Muhammad-Alli/Portable-weather-station/Hardware/PCB.png

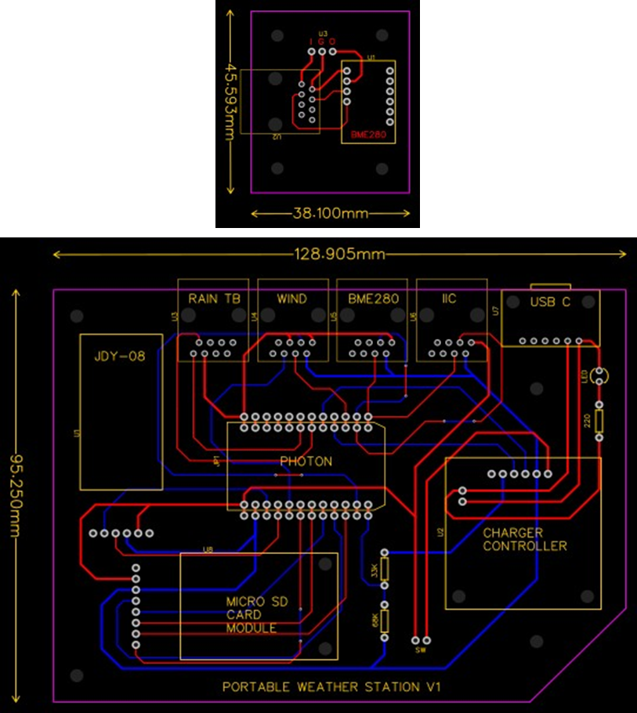
Hardware/PCB.png
