Muhammad-Alli/Portable-weather-station/Docs/Portable Weather Station_Project Summary.pdf

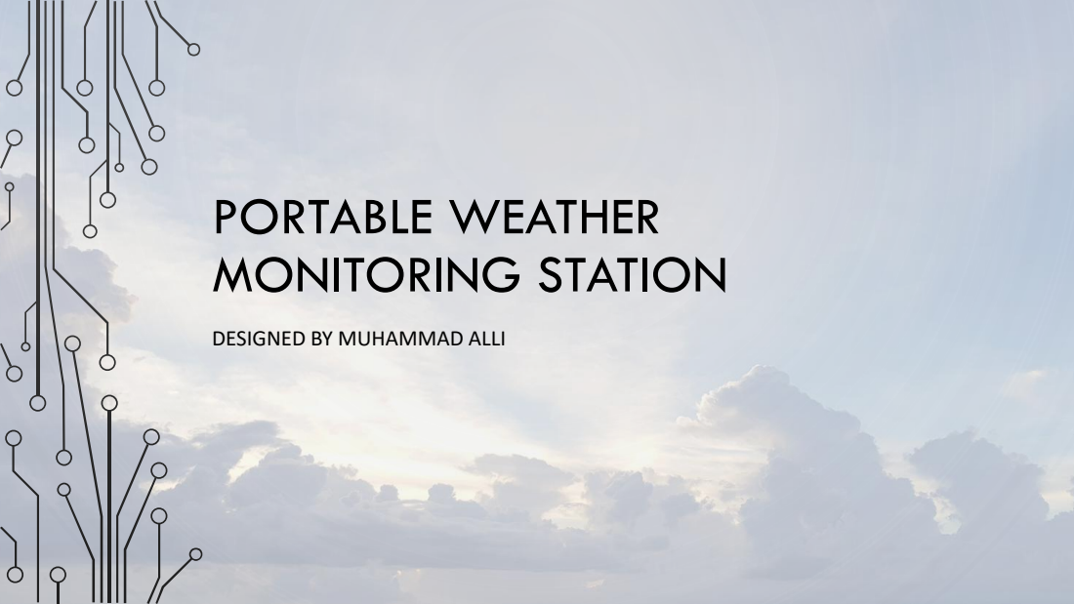
[picture p40: page 1]
PORTABLE WEATHER MONITORING STATION

DESIGNED BY MUHAMMAD ALLI

# Design Process

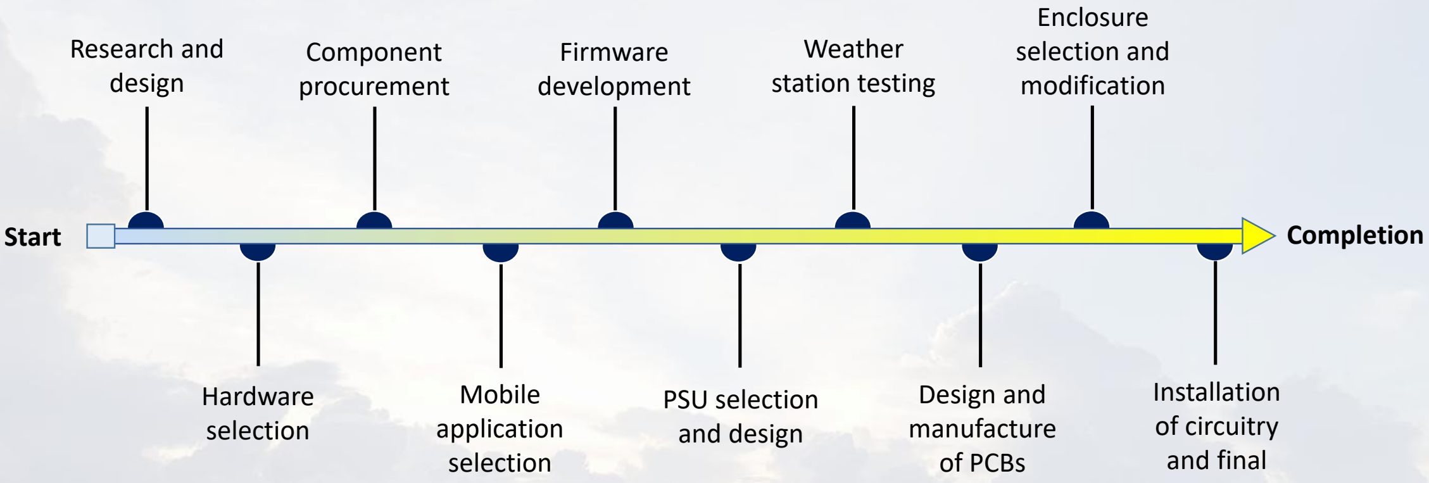
[picture p41: figure]
Start; Completion; Research and design; Mobile application selection; Hardware selection; Component procurement; Firmware development; PSU selection and design; Weather station testing; Design and manufacture of PCBs; Enclosure selection and modification; Installation of circuitry and final

testing

# Design process

# Background

Purpose:

To design and build a portable weather station that is capable of measuring and logging weather conditions in South Africa (all weather variable ranges were informed by the extremist weather conditions ever recorded in the country up to the time when this project was completed).

Applications:

Various industries:
- Agriculture: Irrigation control;
- Construction: Ensure employee safety when working at heights;
- Aviation: Ensure safe airplane landings and take-offs;
- Meteorology: Study of local weather conditions.

Design specifications:
•
- communicates sensor data to a mobile application via Bluetooth;
- has a 12-hour minimum period of operation;
- is able to log timestamped weather data.
Weather Variable | Design specification | Tolerance
Temperature | -22 to 55 °C | 2 °C
Pressure | 600 to 1050 hPa | ±10 hPa
Humidity | 0 to 100% | ±5%
Wind speed | 0 to 190 km/hr | ±10%
Wind direction | N, NE, E, SE, S, SW, W, NW | ±5%
Rain | 0 to 28 mm/hr | ±2 mm/hr

# Design

Block diagram:

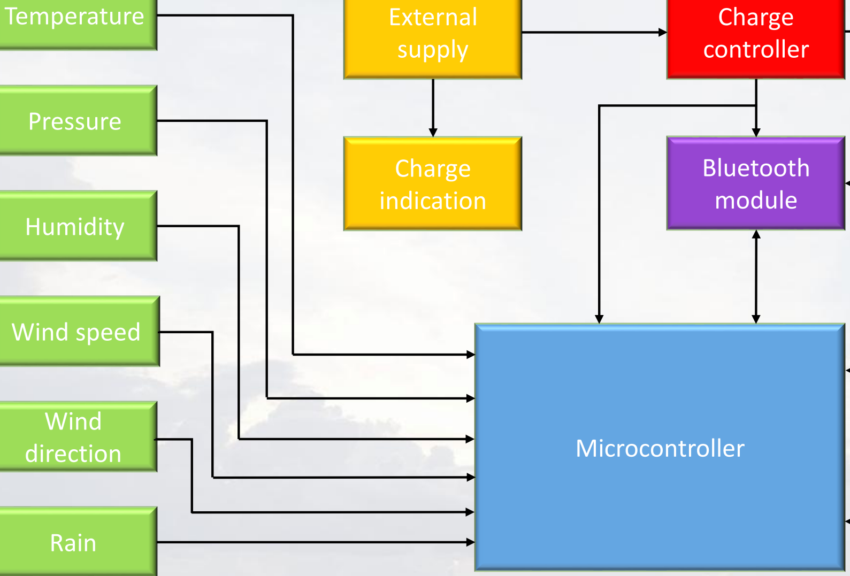
[picture p42: figure]
Temperature; Pressure; Humidity; Wind direction; Wind speed; Rain; Microcontroller; Charge controller; Bluetooth module; External supply; Charge indication

Rechargeable
battery

Battery
monitoring

Smart phone
application

Data logger

# Sensor selection

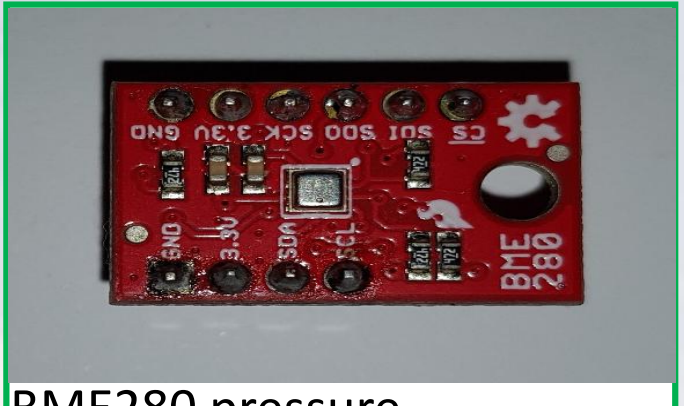
[picture p43: figure]
BME280 pressure
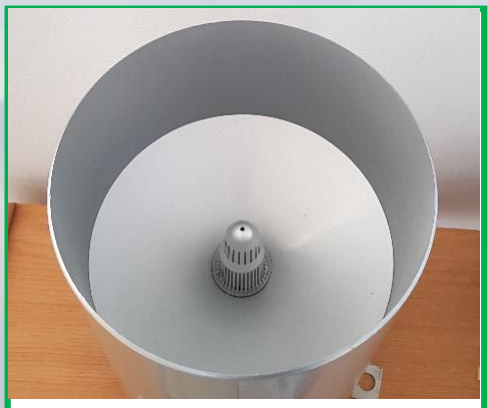
[picture p44: figure]

Sensor | Sensor Resolution | Sensor Range | Design specification
BME280: Temperature | 0.01 °C | -40 to 85 °C | -22 to 55 °C
BME280: Pressure | 0.18 Pa | 300 to 1100 hPa | 600 to 1050 hPa
BME280: Humidity | 0.008% | 0 to 100% | 0 to 100%
Davis 6410: Wind speed | 0.905 km/hr | 0 to 322 km/hr | 0 to 190 km/hr
Davis 6410: Wind direction | 1º | 0 to 360º | N, NE, E, SE, S, SW, W, NW
BGT WS-601ABS2: Rain | 0.8 mm/hr | 0 to 240 mm/hr | 0 to 28 mm/hr
Sensors: | Technical summary:

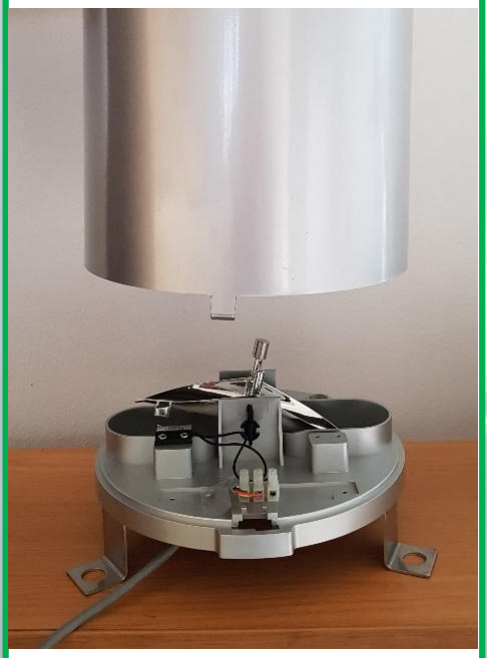
[picture p45: figure]

BGT WS-601ABS2
Rain Sensor

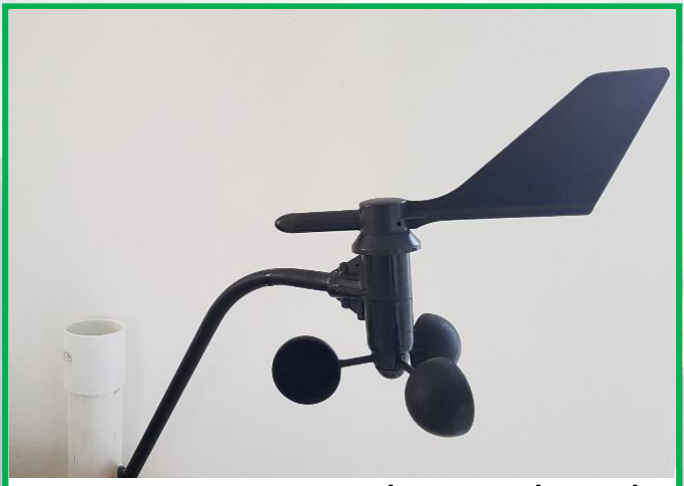
[picture p46: figure]

Davis 6410 wind speed and
direction sensor

temperature, and
humidity sensor

BME280 pressure,
temperature and humidity
sensor

Sensor | Sensor error | Design Tolerance
Wind speed | 8.3% (speed > 10m/s) 1m/s (speed < 10m/s) | 10% (speed > 10m/s) 1m/s (speed < 10m/s)
Wind direction | 4º | 5º
Temperature | 1.4 ℃ | 2 ℃
Humidity | 1.75% | 5%
Pressure | 1.46 hPa | 10 hPa
Rain | 0.8 mm/hr | 2 mm/hr

# Testing Results

Operation | Desired period of operation | Actual period of operation
Without cycling sleep mode | 12 hours | 16 hours and 41 minutes
With cycling sleep mode | 12 hours | 18 hours and 17 minutes

# Weather station main hardware and interface

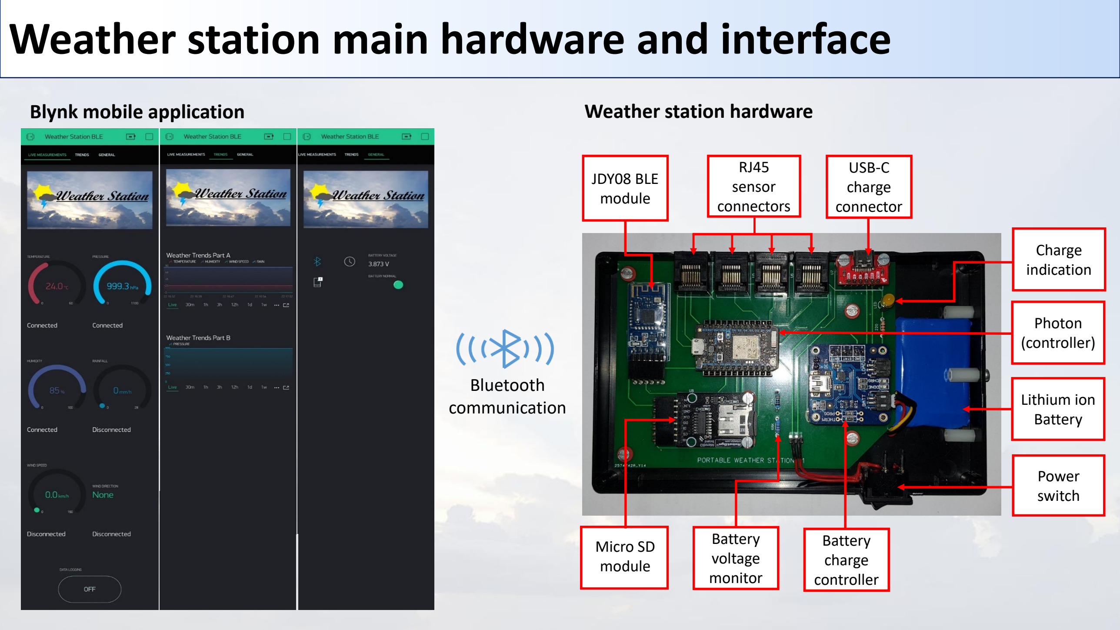
[picture p47: page 7]

Micro SD
module

Power
switch

RJ45
sensor
connectors

USB-C
charge
connector
Blynk mobile application | Weather station hardware

JDY08 BLE
module

Charge
indication

Photon
(controller)

Lithium ion
Battery

Battery
charge
controller

Battery
voltage
monitor

Bluetooth
communication

# Enclosure

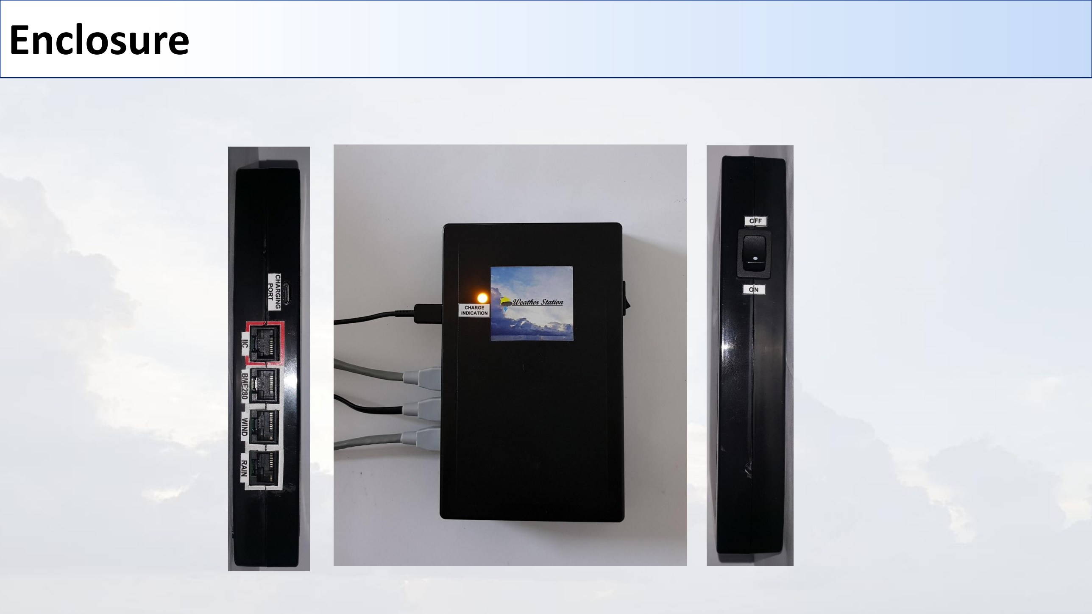
[picture p48: page 8]
